lj314159/gimbal_project/Computer_Vision_Tracking_Gimbal_Summary.pdf

## Autonomous Computer Vision Tracking Gimbal

Feb 2026 – Mar 2026 | Sole Creator

Project Overview

Designed and manufactured a hardware-software integrated system to replace imprecise manual tracking with autonomous target identification. Developed a functional proof of concept capable of maintaining a target in a centered frame across a 180-degree field of view with zero human intervention.

Technical Stack

- Design / CAD: Onshape (Design, Assembly, Reference Geometry)
- Manufacturing: 3D Printing (Ultimaker S5)
- Compute: NVIDIA Jetson Xavier AGX Edge Computer
- Microcontroller: OpenRB-150 (Firmware & Command Processing)
- Actuation: Dynamixel Servos (High-precision Serial Communication)
- Vision & Sensing: MediaPipe (Inference), OpenCV (Frame Acquisition, Image Processing, HUD Overlay), Arducam Global Shutter Camera

Key Engineering Contributions

- Mechanical Design: Engineered a pan-tilt gimbal in Onshape. Prioritized structural rigidity and compactness over center-of-mass alignment to minimize the moment of inertia within the footprint of the servos.
- Firmware Architecture: Programmed a Finite State Machine on the OpenRB-150 microcontroller to process commands from the Jetson. This architecture ensured deterministic transitions between system states, including idle, target acquisition, and active tracking.
- Vision Pipeline: Integrated an Arducam Global Shutter camera to eliminate motion blur. Developed a multi-stage pipeline using OpenCV for frame acquisition and image preprocessing. Utilized MediaPipe for real-time target inference and centroid calculation.
- Visual Feedback (HUD): Designed and implemented a real-time Head-Up Display (HUD) using OpenCV to overlay target bounding boxes and tracking status for assistance during live testing.
- Control Logic & Optimization: Developed a pipeline to translate target offsets into real-time servo coordinates. Utilized internal torque sensing capabilities of the Dynamixel servos to compensate for the unbalanced center of mass and ensure smooth motion.
- Structural Integrity: Iteratively redesigned motor mounts with reinforced geometry to eliminate flex during high-speed stops. Managed 3D printing tolerances for press-fit components and moving parts.

1

Results & Impact

- Performance: Successfully validated the prototype by tracking targets moving at walking speeds from a distance of 5 feet.
- Efficiency: Eliminated system overshooting (hunting) through iterative tuning of the movement logic and optimized computer vision scripts for the Xavier AGX GPU.
- Reliability: Achieved 100% assembly accuracy by leveraging manufacturer-provided 3D models for off-the-shelf parts within the Onshape assembly.

Control Methodology

The system utilizes a closed-loop approach where the pixel distance from the target centroid to the frame center is calculated in real-time. To prevent unnecessary jitter and mechanical "hunting" during minor oscillations, a central deadband (buffer zone) was implemented; the gimbal remains stationary if the centroid is within this defined region. Once the target exits the buffer, the error is processed through a tuned gain to update the servo position via the microcontroller.

2
