lj314159/gimbal_project/Bill_Of_Materials.pdf

## Bill of Materials

Project: Autonomous Computer Vision Tracking Gimbal Date: March 2026

### 1. Electronics & Actuators

Item | Description | Qty | Source / Part #
Servo Motor | DYNAMIXEL XL430-W250-T (High-Torque) | 2 | Robotis
Microcontroller | OpenRB-150 (Arduino-compatible) | 1 | Robotis
Power Supply | SMPS 12V 5A PS-10 [US-110V] | 1 | Robotis
Power Board | SMPS2Dynamixel Power Hub | 1 | Robotis
Cable (180mm) | Robot Cable-X3P Convertible (10-pack) | 1 | Robotis

### 2. Vision System

Item | Description | Qty | Source / Part #
Edge Computer | NVIDIA Jetson Xavier AGX | 1 | NVIDIA
Camera | Arducam 2MP Global Shutter (OV2311) | 1 | Amazon / B096ZSSCGH

### 3. Mechanical Hardware

Item | Description | Qty | Source / Part #
Bearing (Large) | Flanged, 10mm Shaft ID, 7mm Wide | 1 | McMaster / 4390N115
Shaft Collar | Washdown Clamping, 10mm Diameter | 1 | McMaster / 3761N105
Machine Screws | M2 x 0.4mm Socket Head, 8mm Long | 100 | McMaster / 91292A832
Plastic Screws | M2.63 Torx Plus Rounded Head, 10mm Long | 50 | McMaster / 99397A354

### 4. Raw Materials & Manufacturing

Item | Description | Qty | Notes
3D Filament | PLA Plastic (High Density) | — | Used on Ultimaker S5
Reference CAD | Manufacturer-provided 3D Models | — | Used for 100% fitment

1
