lj314159/gimbal_project/(commit log)

2026-04-04 add jetson specific script
2026-04-10 added stl files
